ReXT3D/Voron-Mods/README.md

# Voron-Mods
 Modifications, tweaks and experiments on my Voron 2.4
