ReXT3D/Voron-Mods/OMRON Z-15HS-B Mount/images/switch.jpg

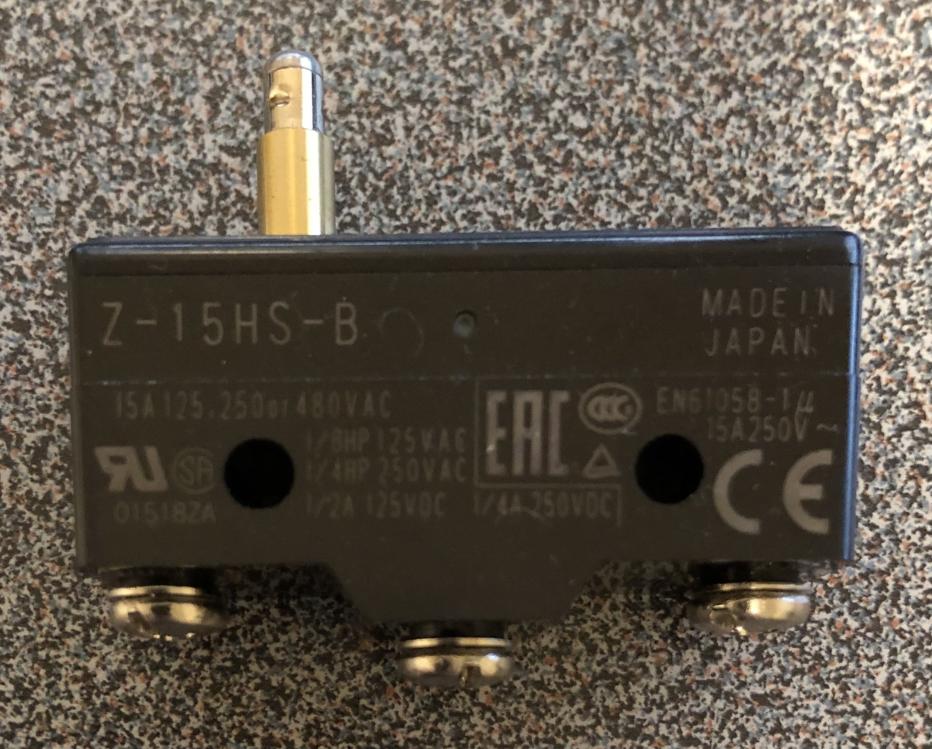
OMRON Z-15HS-B Mount/images/switch.jpg
