ReXT3D/Voron-Mods/Acoustic Fan Grilles/CAD/Acoustic Fan Grill v3.step

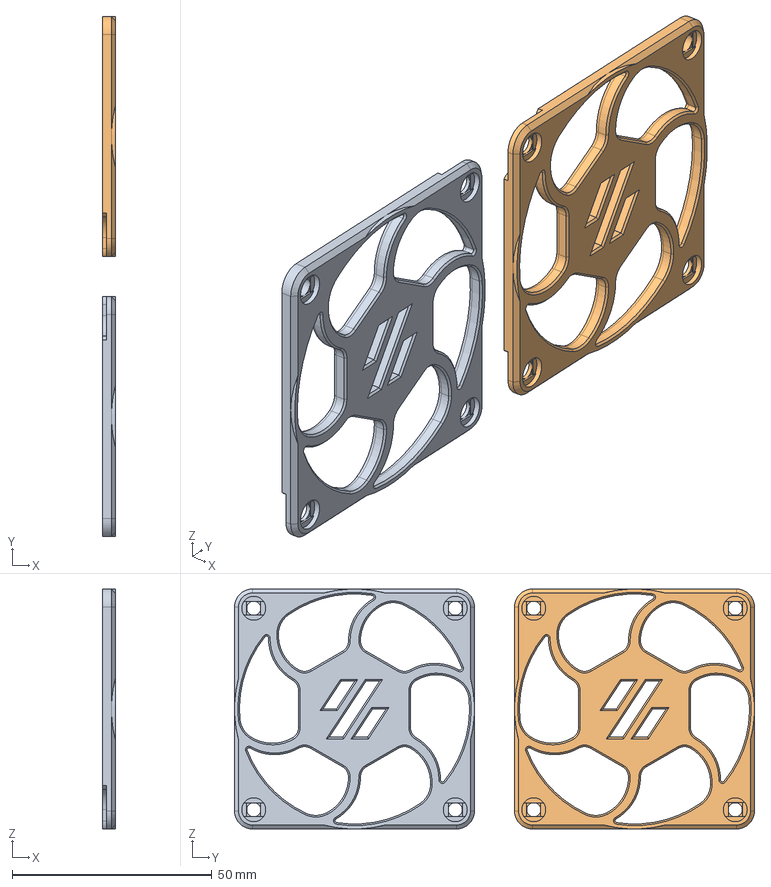
[picture p20: CAD file, 2023-01-17]
Acoustic Fan Grilles/CAD/Acoustic Fan Grill v3.step
3.20 x 130.0 x 60.0 mm
Fan Grill A (1)
Fan Grill B (1) (1)
