ReXT3D/Voron-Mods/Low Profile PSU Stabilizer/CAD/Low Profile PSU Stabilizer.step

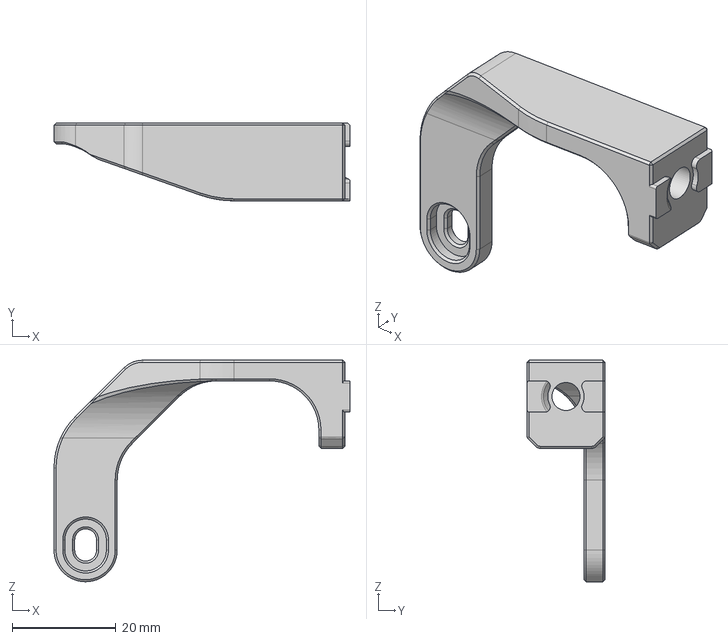
[picture p21: CAD file, 2023-01-03]
Low Profile PSU Stabilizer/CAD/Low Profile PSU Stabilizer.step
57.1 x 15.0 x 42.7 mm
