ReXT3D/Voron-Mods/OMRON Z-15HS-B Mount/CAD/Custom Z Switch Bracket v17.step

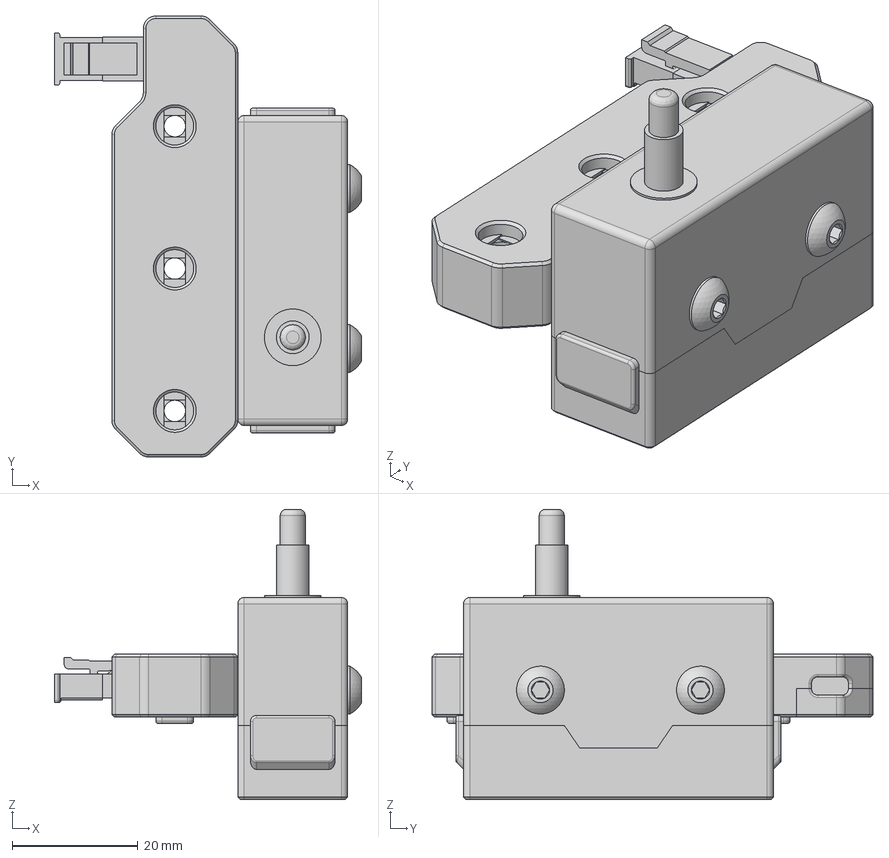
[picture p22: CAD file, 2022-12-27]
OMRON Z-15HS-B Mount/CAD/Custom Z Switch Bracket v17.step
48.8 x 70.0 x 46.1 mm
Z_15HS_B_BASE
90116A201_316 Stainless Steel Pan Head Phillips Screws x 2
Z_15HS_B_ACTUATOR
M4xD6.5xL6.0 x 2
91239A154_Button Head Hex Drive Screw x 2
Cover
