ReXT3D/Voron-Mods/Pimoroni Pi 4 Heatsink Bracket/CAD/Pimoroni Pi 4 Heatsink Bracket.step

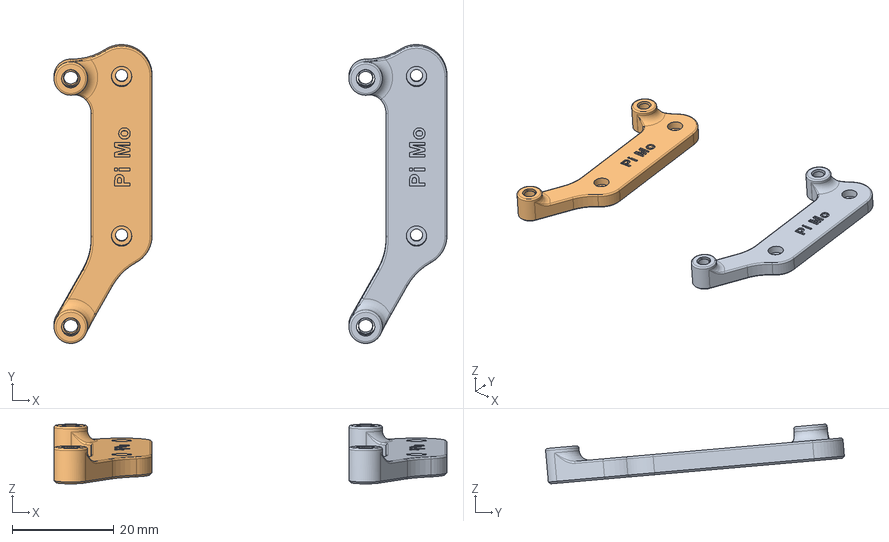
[picture p23: CAD file, 2023-01-08]
Pimoroni Pi 4 Heatsink Bracket/CAD/Pimoroni Pi 4 Heatsink Bracket.step
77.3 x 58.8 x 11.8 mm
