ReXT3D/Voron-Mods/Z Belt Covers For Harness/CAD/Z Belt Covers for Harness v10.step

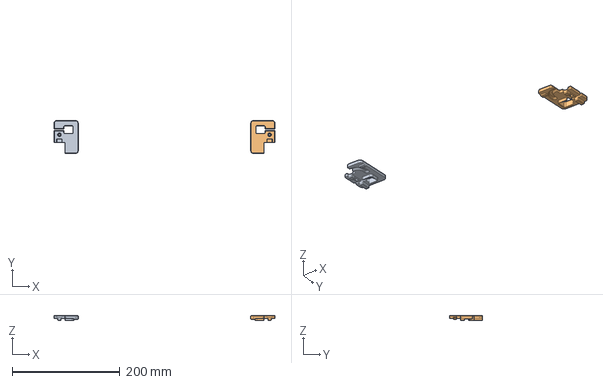
[picture p24: CAD file, 2023-01-08]
Z Belt Covers For Harness/CAD/Z Belt Covers for Harness v10.step
410.0 x 61.0 x 9.00 mm
