ReXT3D/Voron-Mods/Z Chain Guide Thermistor/CAD/Z Chain Guide Thermistor v6.step

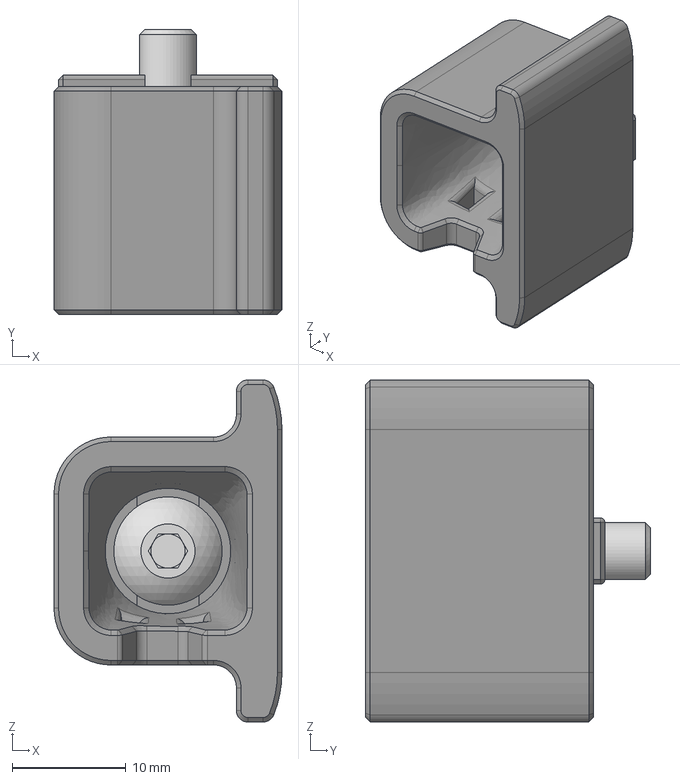
[picture p25: CAD file, 2023-01-08]
Z Chain Guide Thermistor/CAD/Z Chain Guide Thermistor v6.step
20.0 x 25.0 x 30.0 mm
