ReXT3D/Voron-Mods/(commit log)

2022-12-27 Added OMRON Z-15HS-B Mount
    [Custom Z Switch Bracket v17.step]
2022-12-27 Amended BOM
2023-01-03 Introduced Low Profile PSU Stabilizer
    [Low Profile PSU Stabilizer.step]
2023-01-03 Image names and path fixes
    [Low Profile PSU Stabilizer.step]
2023-01-03 Introduced Z Belt Covers For Harness
    [Z Belt Covers for Harness.step]
2023-01-08 Introduced Z Chain Guide Thermistor
    [Z Chain Guide Thermistor v6.step]
2023-01-08 Introduced Pimoroni Pi 4 Heatsink Bracket
    [Pimoroni Pi 4 Heatsink Bracket.step]
2023-01-08 Increased clearance to captive nut to avoid potential interference
    [Z Belt Covers for Harness v10.step, Z Belt Covers for Harness.step]
2023-01-17 Introduced acoustic fan grilles
    [Acoustic Fan Grill v3.step]
2023-01-30 Added results of Z homing accuracy & repeatability study
